EvriposRobotics/WRO-FE/schemes/electronic-electric_components_wiring.png

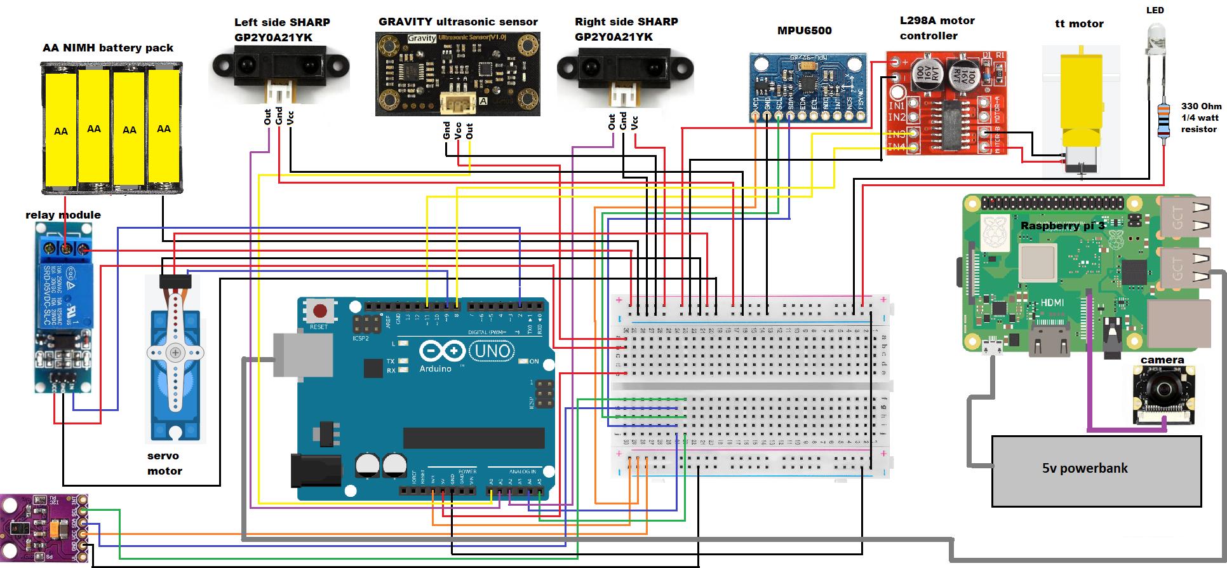
schemes/electronic-electric_components_wiring.png
