EvriposRobotics/WRO-FE/v-photos/v_left.jpg

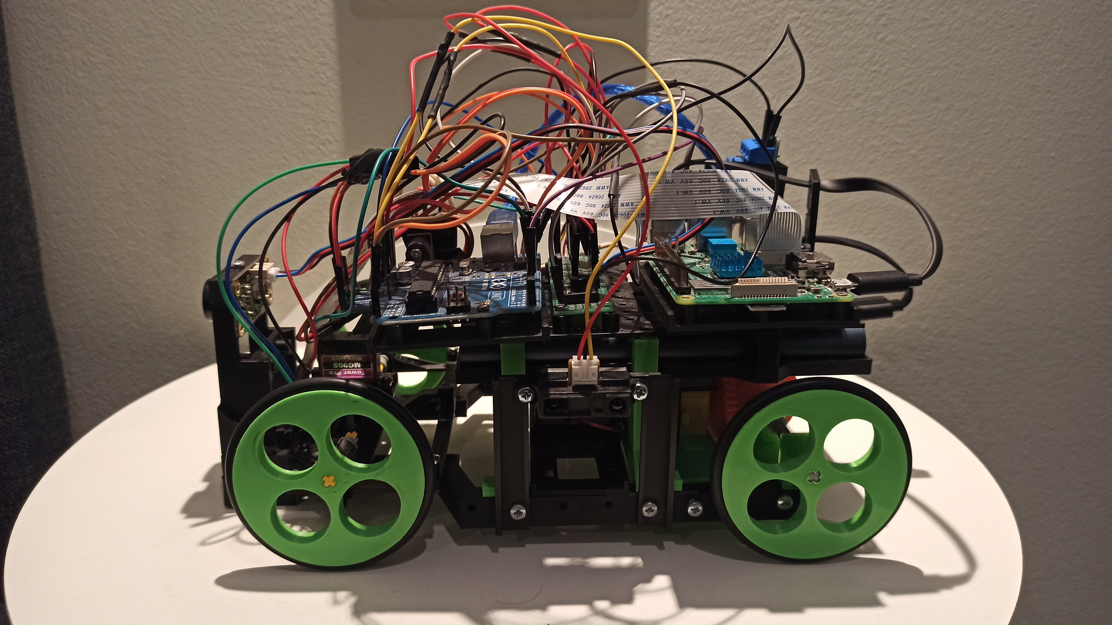
v-photos/v_left.jpg
