EvriposRobotics/WRO-FE/src/README.md

**Source code files**

The folder named "arduino_code" contains two subfolders:
- The one with the name "qualification_run_code" contains the code that Arduino UNO SBM runs at the qualification run.
- The other with the name "final_run_code" contains respectively the code that Arduino UNO SBM runs at the final run.

The folder named "raspberry_pi_code" contains the python code that Raspberry Pi 3 SBC runs on both runs.
