EvriposRobotics/WRO-FE/schemes/README.md

**Electronic/electric components wiring diagram**

 - Wires in gray color: the two USB cables that connect a)Arduino Uno with Raspberry Pi 3 and b)Raspberry Pi 3 with the powerbank
 - Wires in purple color: the special caCSI type cable than connects Raspberry Pi 3 to the Raspberry Pi  camera module
 - Wires in red color: the power lines at 5v and at 4.8v 
 - Wires in orange color: the power lines at 3.3v
 - Wires in black color: the ground lines
 - Wires in the other colors: various signal input-output cables connecting on Arduino Uno
