EvriposRobotics/WRO-FE/v-photos/v_back.jpg

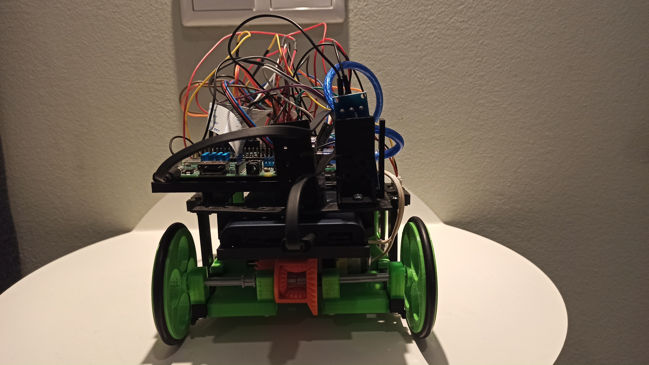
v-photos/v_back.jpg
