EvriposRobotics/WRO-FE/v-photos/v_bottom.jpg

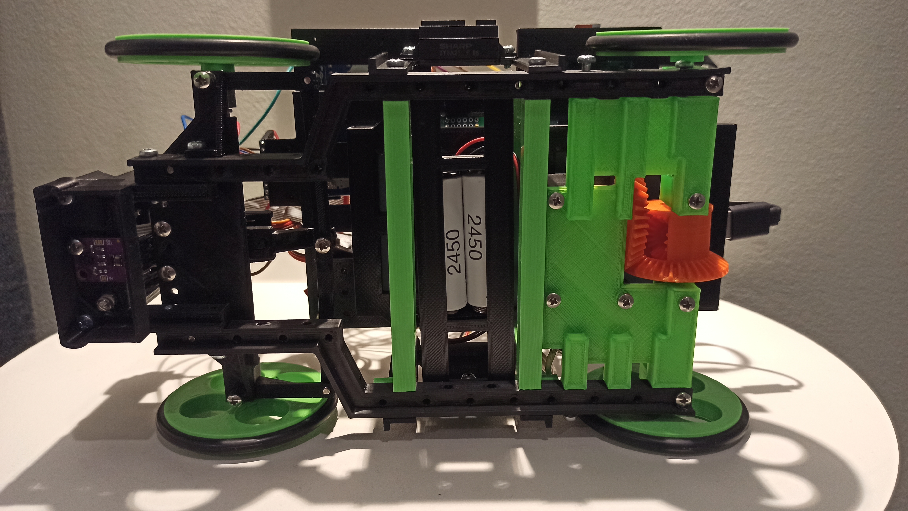
v-photos/v_bottom.jpg
