EvriposRobotics/WRO-FE/v-photos/v_front.jpg

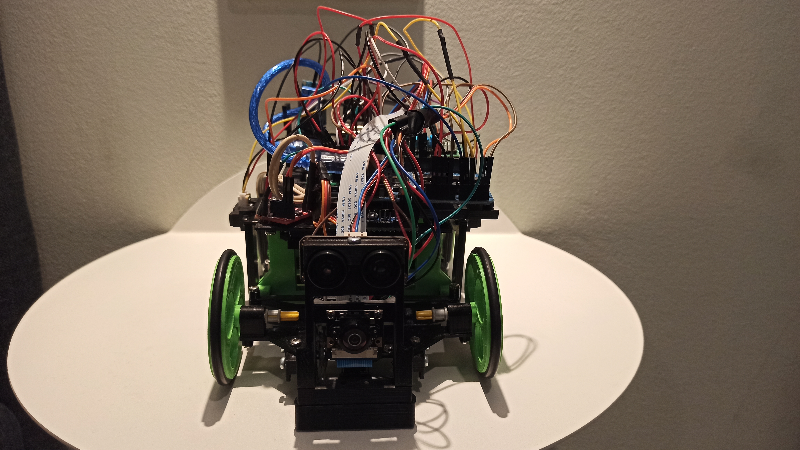
v-photos/v_front.jpg
