EvriposRobotics/WRO-FE/v-photos/v_right.jpg

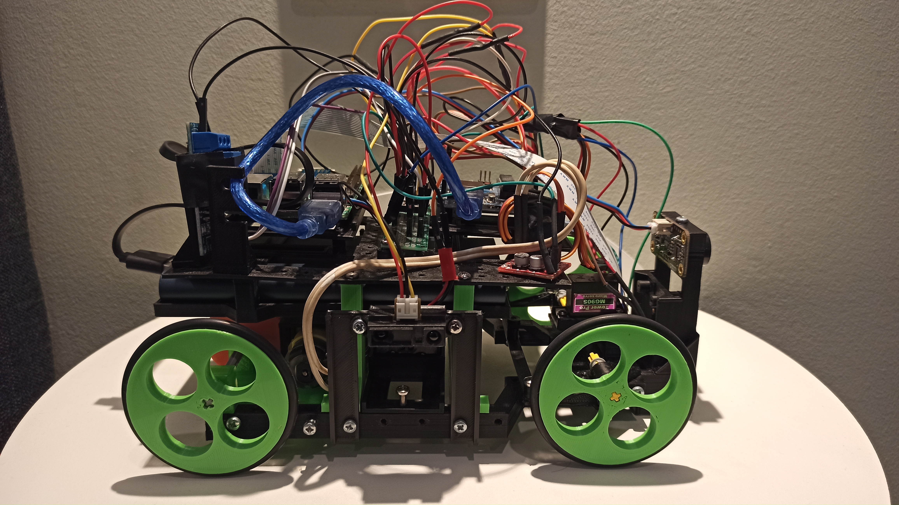
v-photos/v_right.jpg
