EvriposRobotics/WRO-FE/v-photos/v_top.jpg

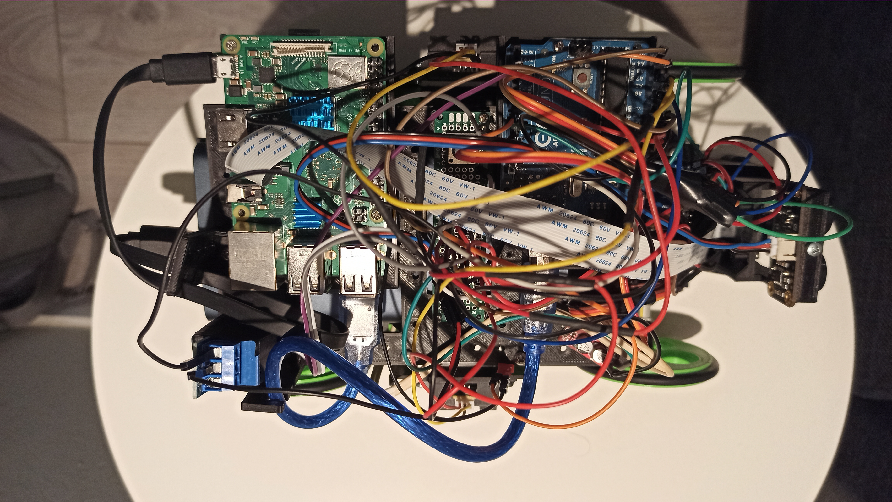
v-photos/v_top.jpg
